tk20dk/elmo/kicad/elmo-pcb.png

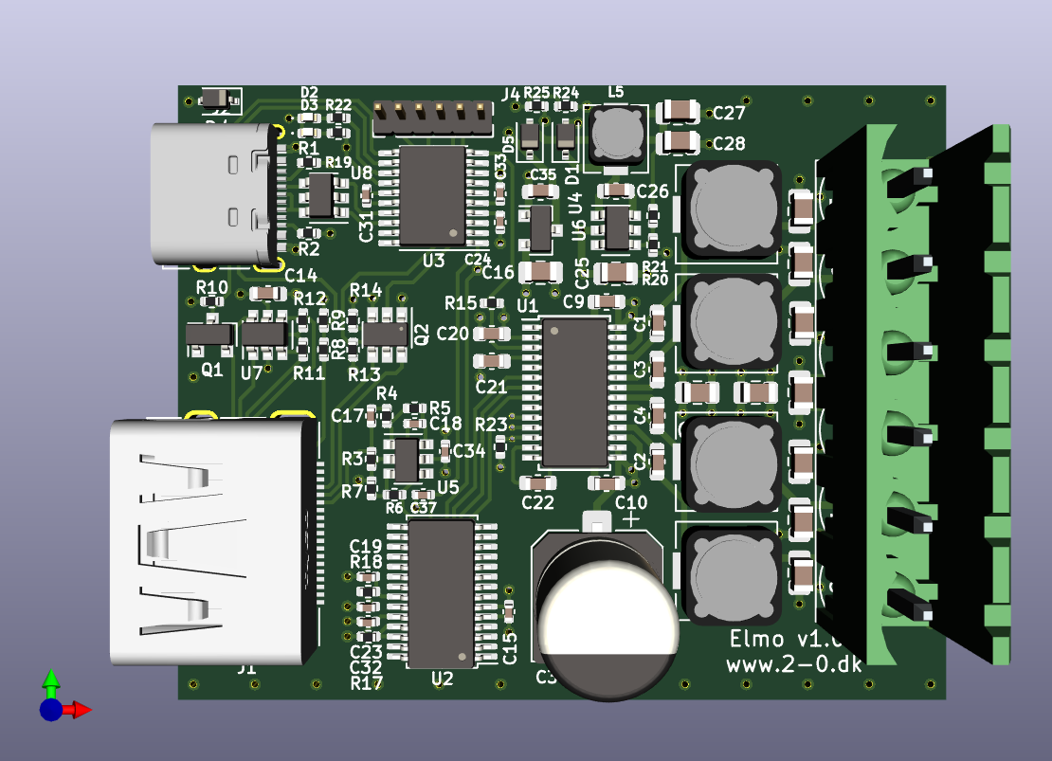
kicad/elmo-pcb.png
