tk20dk/elmo/kicad/elmo-pcb.pdf

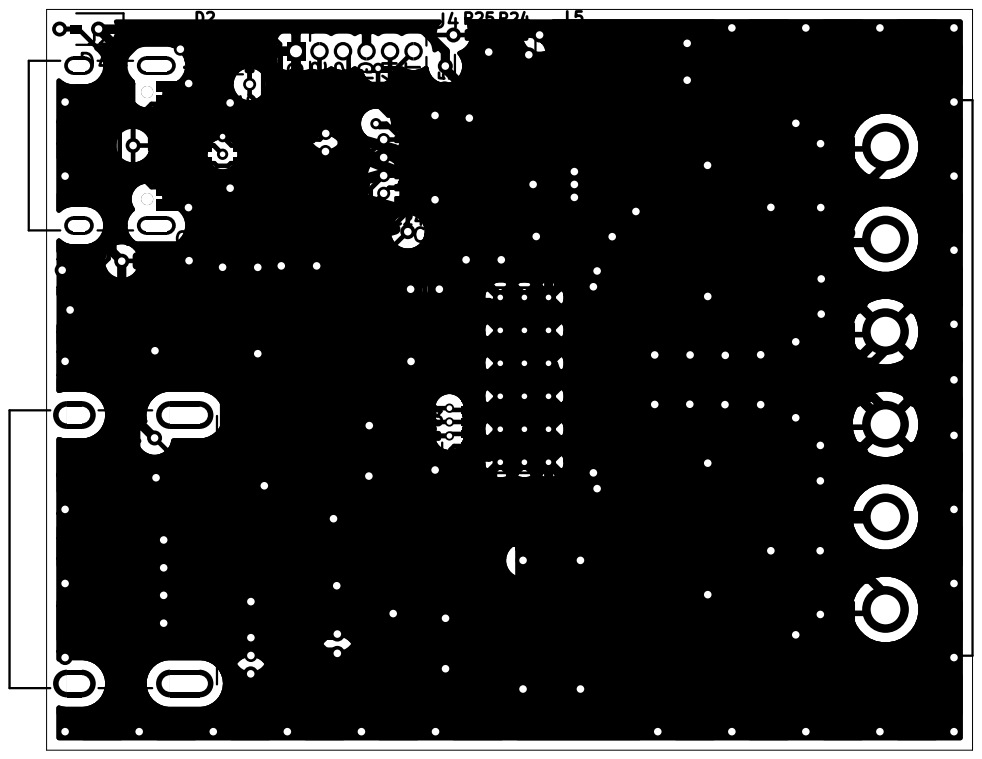
[picture p2: page 1]
