tk20dk/elmo/kicad/elmo-sch.pdf

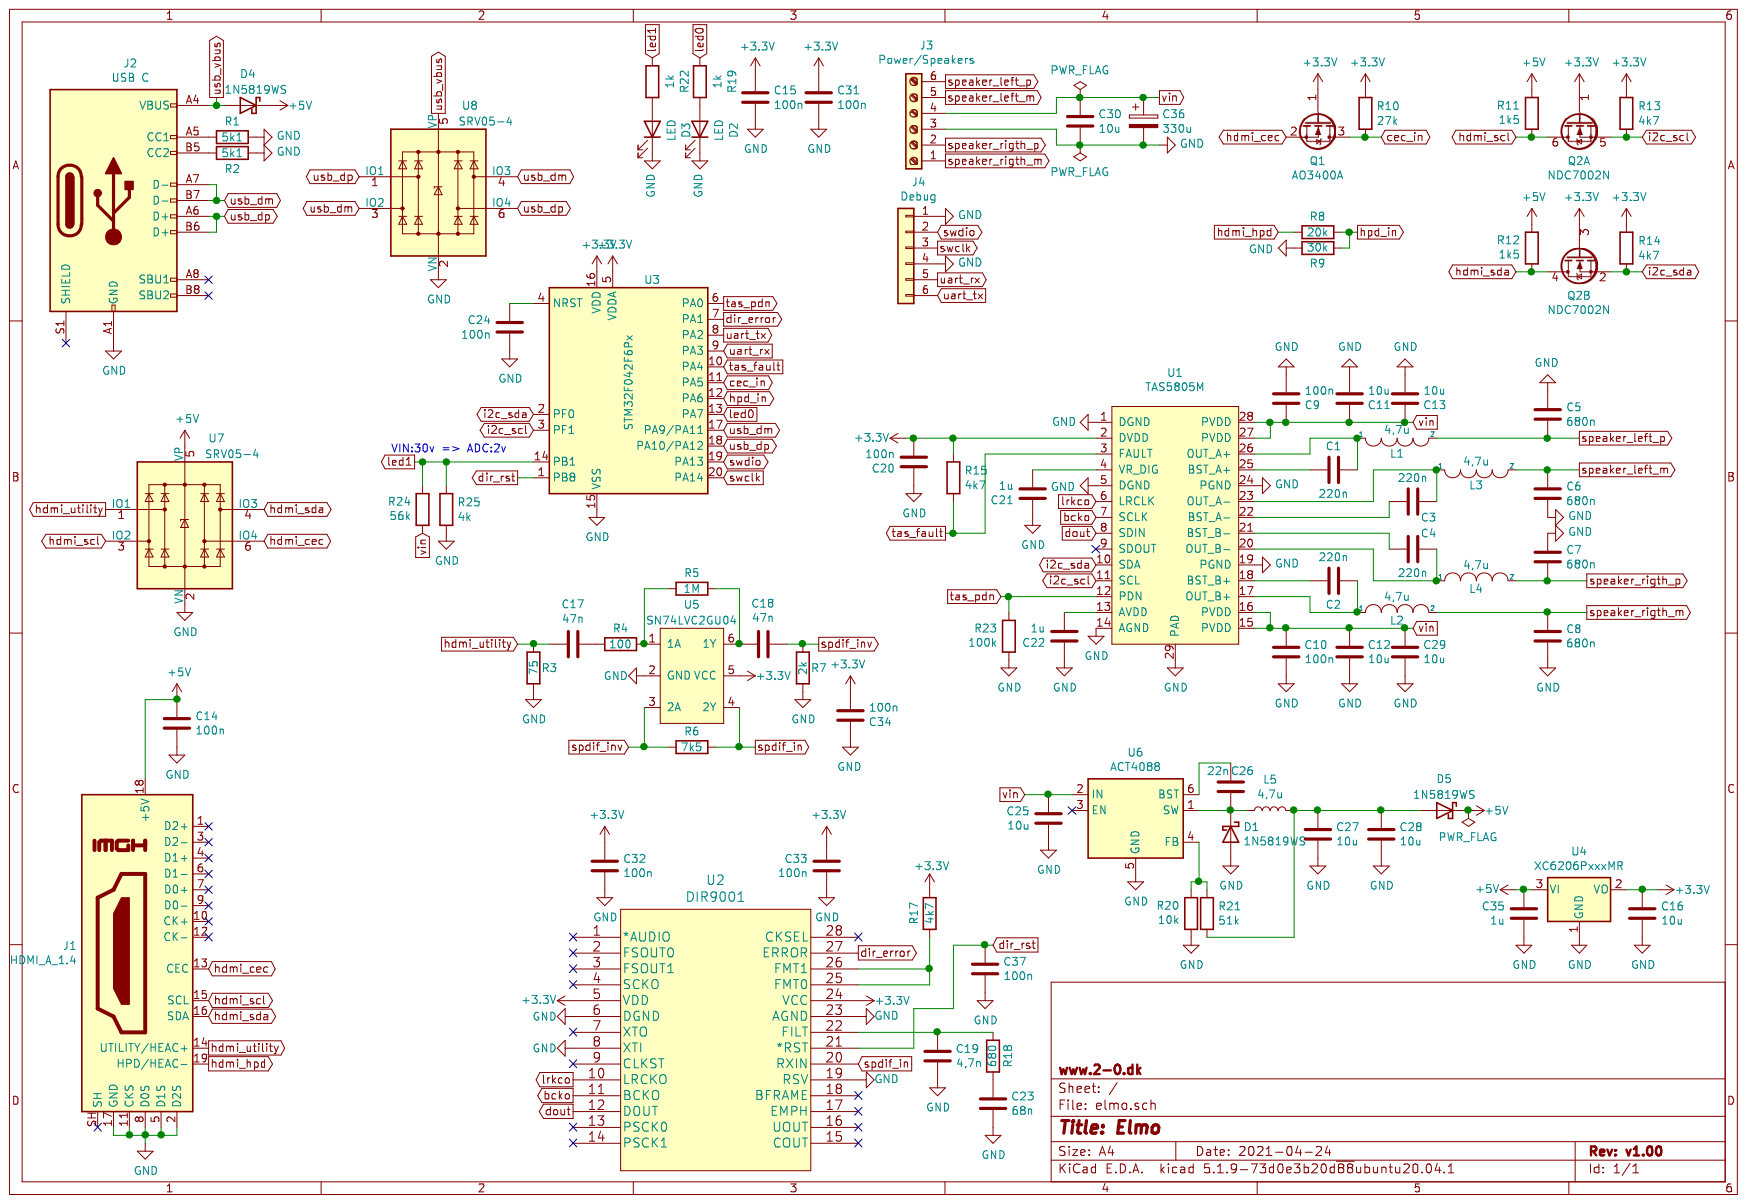
[picture p3: page 1]
