tk20dk/elmo/kicad/elmo.kicad_pcb

## KiCad design kicad/elmo.kicad_pcb (2021-04-25)

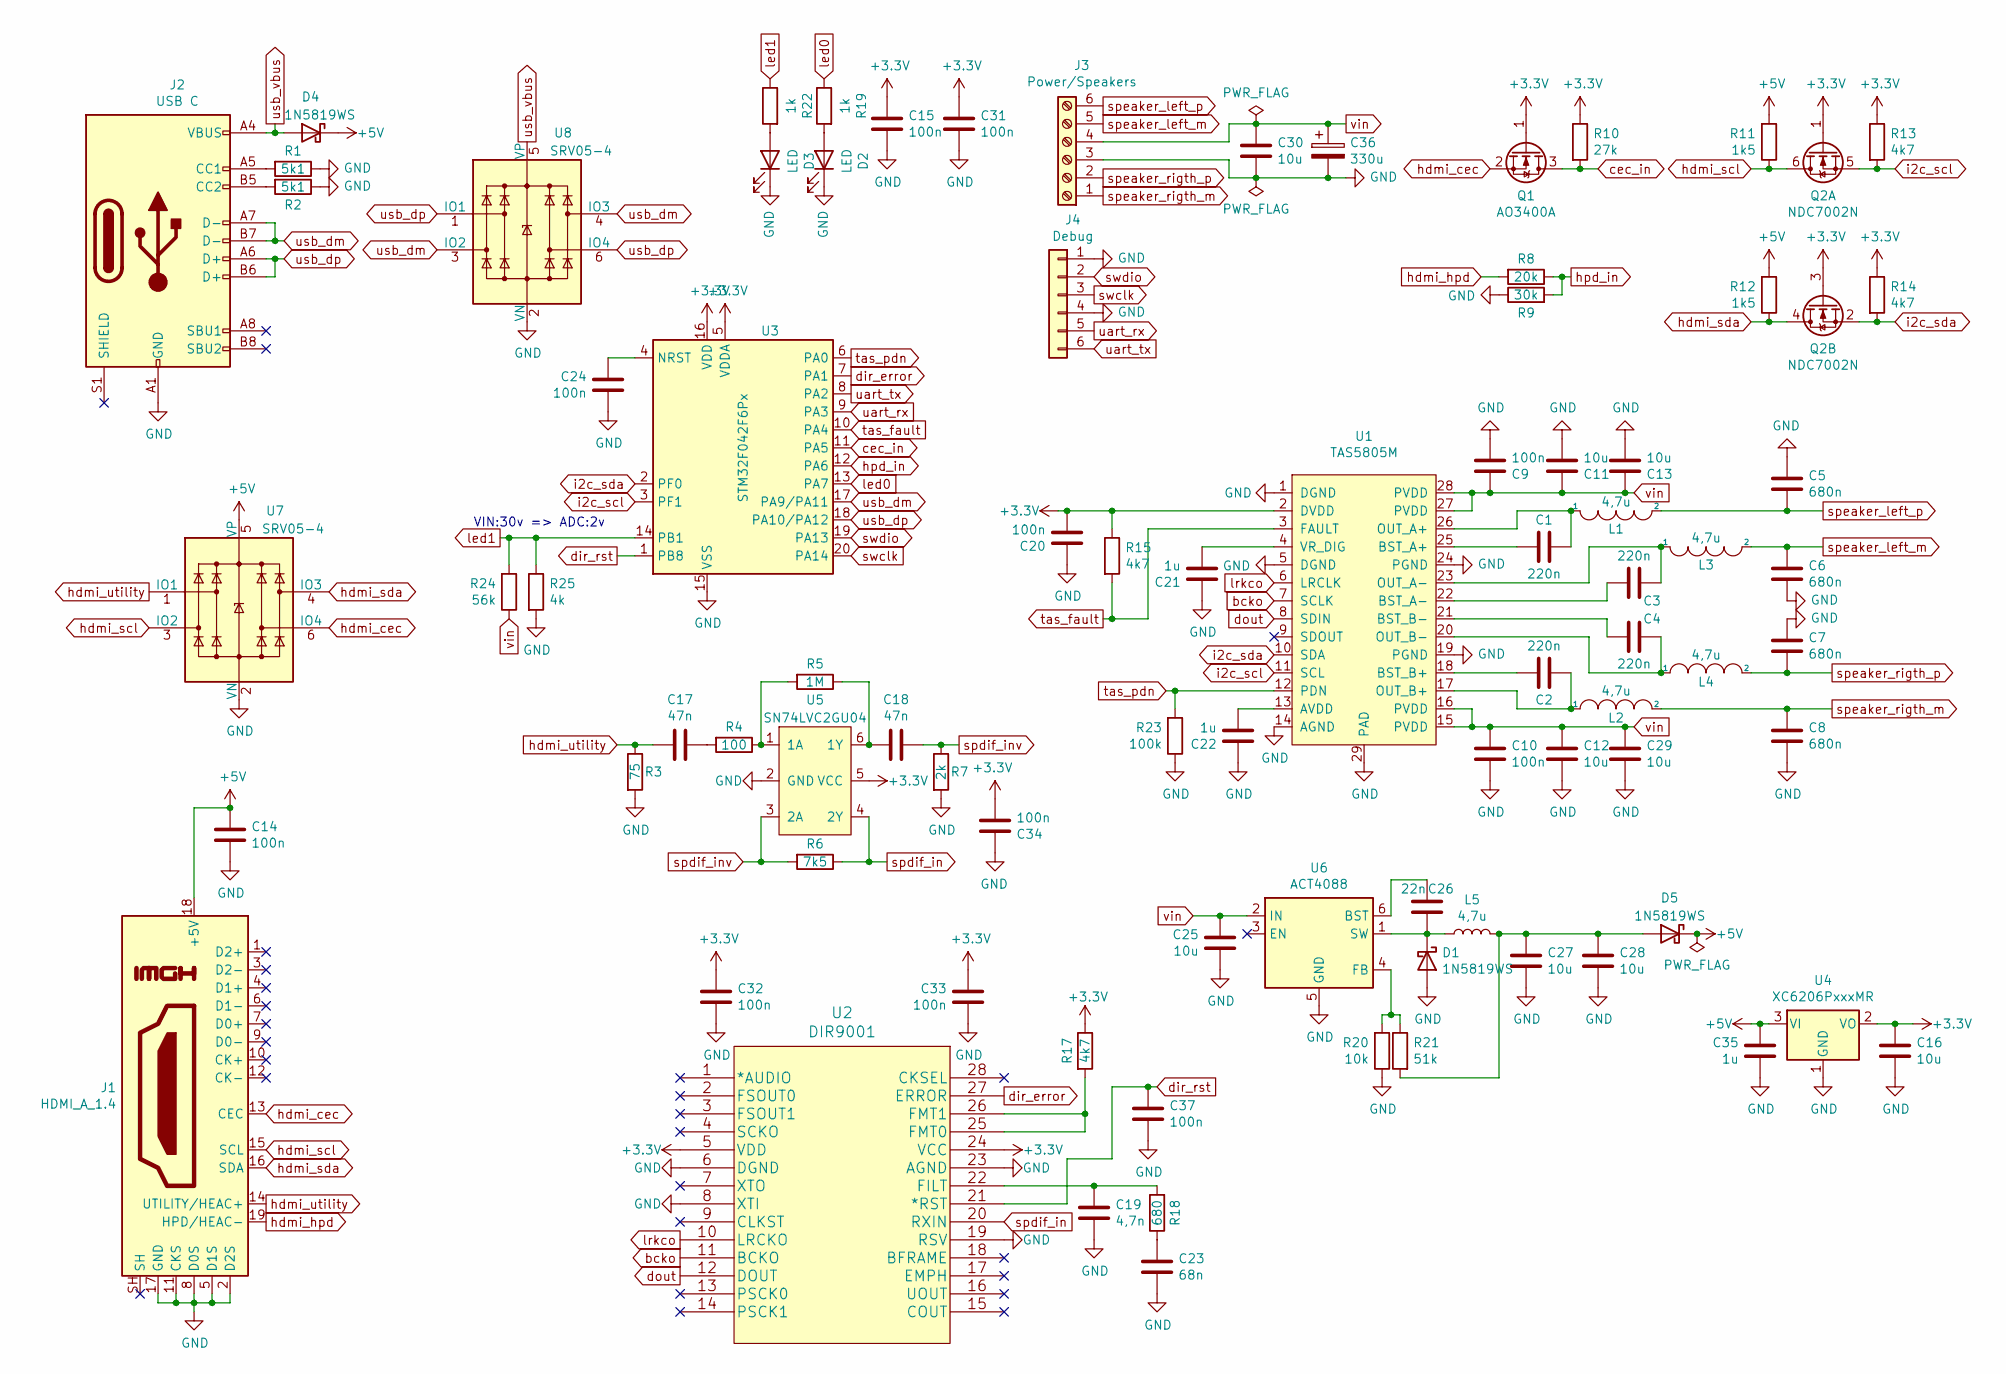
[picture p4: schematic elmo.sch]

Parts:
C1, C2, C3, C4: 220n; C_0603_1608Metric
C5, C6, C7, C8: 680n; C_0805_2012Metric
C9, C10, C14, C20: 100n; C_0603_1608Metric
C11, C12, C13, C16, C25, C27, C28, C29, C30: 10u; C_0805_2012Metric
C15, C24, C31, C32, C33, C34, C37: 100n; C_0402_1005Metric
C17, C18: 47n; C_0402_1005Metric
C19: 4,7n; C_0402_1005Metric
C21, C22, C35: 1u; C_0603_1608Metric
C23: 68n; C_0402_1005Metric
C26: 22n; C_0603_1608Metric
C36: 330u; CP_Elec_8x11.9
D1, D4, D5: 1N5819WS; D_SOD-323
D2, D3: LED; LED_0402_1005Metric
J1: HDMI_A_1.4; HDMI_A_19P
J2: USB C; USB_C_Receptacle_XKB_U262-16XN-4BVC11
J3: Power/Speakers; CONN_5MM_01x06
J4: Debug; PinHeader_1x06_P1.27mm_Vertical
L1, L2, L3, L4: 4,7u; L_6.3x6.3_H3
L5: 4,7u; L_4.1x4.1_H1.75
Q1: AO3400A; SOT-23
Q2: NDC7002N; SuperSOT-6
R1, R2: 5k1; R_0402_1005Metric
R3: 75; R_0402_1005Metric
R4: 100; R_0402_1005Metric
R5: 1M; R_0402_1005Metric
R6: 7k5; R_0402_1005Metric
R7: 2k; R_0402_1005Metric
R8: 20k; R_0402_1005Metric
R9: 30k; R_0402_1005Metric
R10: 27k; R_0402_1005Metric
R11, R12: 1k5; R_0402_1005Metric
R13, R14, R15, R17: 4k7; R_0402_1005Metric
R18: 680; R_0402_1005Metric
R19, R22: 1k; R_0402_1005Metric
R20: 10k; R_0402_1005Metric
R21: 51k; R_0402_1005Metric
R23: 100k; R_0402_1005Metric
R24: 56k; R_0402_1005Metric
R25: 4k; R_0402_1005Metric
U1: TAS5805M; HTSSOP-28-1EP_4.4x9.7mm_P0.65mm_EP3.4x9.5mm_Mask2.4x6.17mm_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
U2: DIR9001; TSSOP-28_4.4x9.7mm_P0.65mm
U3: STM32F042F6Px; TSSOP-20_4.4x6.5mm_P0.65mm
U4: XC6206PxxxMR; SOT-23
U5: SN74LVC2GU04; SOT-23-6
U6: ACT4088; SOT-23-6
U7, U8: SRV05-4; SOT-23-6

Connections:
+3V3: C15.1, C16.1, C20.2, C31.1, C32.1, C33.1, C34.2, Q1.1 (G), Q2.1 (G), Q2.3 (G), R10.1, R13.1, R14.1, R15.1, R17.1, U1.2 (DVDD), U2.5 (VDD), U2.24 (VCC), U3.5 (VDDA), U3.16 (VDD), U4.2 (VO), U5.5 (VCC)
+5V: C14.1, C35.1, D4.1 (K), D5.1 (K), J1.18 (+5V), R11.2, R12.2, U4.3 (VI), U7.5 (VP)
GND: C5.1, C6.2, C7.1, C8.2, C9.2, C10.2, C11.2, C12.2, C13.2, C14.2, C15.2, C16.2, C19.2, C20.1, C21.1, C22.1, C23.2, C24.2, C25.2, C27.2, C28.2, C29.2, C30.2, C31.2, C32.2, C33.2, C34.1, C35.2, C36.2, C37.2, D1.2 (A), D2.1 (K), D3.1 (K), J1.2 (D2S), J1.5 (D1S), J1.8 (D0S), J1.11 (CKS), J1.17 (GND), J2.A1 (GND), J2.A12 (GND), J2.B1 (GND), J2.B12 (GND), J3.3, J4.1, J4.4, R1.1, R2.1, R3.2, R7.2, R9.1, R20.1, R23.1, R25.2, U1.1 (DGND), U1.5 (DGND), U1.14 (AGND), U1.19 (PGND), U1.24 (PGND), U1.29 (PAD), U2.6 (DGND), U2.8 (XTI), U2.19 (RSV), U2.23 (AGND), U3.15 (VSS), U4.1 (GND), U5.2 (GND), U6.5 (GND), U7.2 (VN), U8.2 (VN)
unnamed: C1.1, U1.25 (BST_A+)
unnamed: C1.2, L1.1, U1.26 (OUT_A+)
unnamed: C2.1, U1.18 (BST_B+)
unnamed: C2.2, L2.1, U1.17 (OUT_B+)
unnamed: C3.1, U1.22 (BST_A-)
unnamed: C3.2, L3.1, U1.23 (OUT_A-)
unnamed: C4.1, U1.21 (BST_B-)
unnamed: C4.2, L4.1, U1.20 (OUT_B-)
unnamed: C17.1, R4.2
unnamed: C18.1, R5.1, U5.6 (1Y)
unnamed: C19.1, R18.2, U2.22 (FILT)
unnamed: C21.2, U1.4 (VR_DIG)
unnamed: C22.2, U1.13 (AVDD)
unnamed: C23.1, R18.1
unnamed: C24.1, U3.4 (NRST)
unnamed: C26.1, U6.6 (BST)
unnamed: C26.2, D1.1 (K), L5.1, U6.1 (SW)
unnamed: C27.1, C28.1, D5.2 (A), L5.2, R21.2
unnamed: D2.2 (A), R19.2
unnamed: D3.2 (A), R22.2
unnamed: J2.A5 (CC1), R1.2
unnamed: J2.B5 (CC2), R2.2
unnamed: R4.1, R5.2, U5.1 (1A)
unnamed: R17.2, U2.25 (FMT0), U2.26 (FMT1)
unnamed: R20.2, R21.1, U6.4 (FB)
bcko: U1.7 (SCLK), U2.11 (BCKO)
cec_in: Q1.3 (D), R10.2, U3.11 (PA5)
dir_error: U2.27 (ERROR), U3.7 (PA1)
dir_rst: C37.1, U2.21 (*RST), U3.1 (PB8)
dout: U1.8 (SDIN), U2.12 (DOUT)
hdmi_cec: J1.13 (CEC), Q1.2 (S), U7.6 (IO4)
hdmi_hpd: J1.19 (HPD/HEAC-), R8.2
hdmi_scl: J1.15 (SCL), Q2.6 (D), R11.1, U7.3 (IO2)
hdmi_sda: J1.16 (SDA), Q2.4 (D), R12.1, U7.4 (IO3)
hdmi_utility: C17.2, J1.14 (UTILITY/HEAC+), R3.1, U7.1 (IO1)
hpd_in: R8.1, R9.2, U3.12 (PA6)
i2c_scl: Q2.5 (S), R13.2, U1.11 (SCL), U3.3 (PF1)
i2c_sda: Q2.2 (S), R14.2, U1.10 (SDA), U3.2 (PF0)
led0: R19.1, U3.13 (PA7)
led1: R22.1, R24.2, R25.1, U3.14 (PB1)
lrkco: U1.6 (LRCLK), U2.10 (LRCKO)
spdif_in: R6.1, U2.20 (RXIN), U5.4 (2Y)
spdif_inv: C18.2, R6.2, R7.1, U5.3 (2A)
speaker_left_m: C6.1, J3.5, L3.2
speaker_left_p: C5.2, J3.6, L1.2
speaker_rigth_m: C8.1, J3.1, L2.2
speaker_rigth_p: C7.2, J3.2, L4.2
swclk: J4.3, U3.20 (PA14)
swdio: J4.2, U3.19 (PA13)
tas_fault: R15.2, U1.3 (FAULT), U3.10 (PA4)
tas_pdn: R23.2, U1.12 (PDN), U3.6 (PA0)
uart_rx: J4.5, U3.9 (PA3)
uart_tx: J4.6, U3.8 (PA2)
usb_dm: J2.A7 (D-), J2.B7 (D-), U3.17 (PA9/PA11), U8.3 (IO2), U8.4 (IO3)
usb_dp: J2.A6 (D+), J2.B6 (D+), U3.18 (PA10/PA12), U8.1 (IO1), U8.6 (IO4)
usb_vbus: D4.2 (A), J2.A4 (VBUS), J2.A9 (VBUS), J2.B4 (VBUS), J2.B9 (VBUS), U8.5 (VP)
vin: C9.1, C10.1, C11.1, C12.1, C13.1, C25.1, C29.1, C30.1, C36.1, J3.4, R24.1, U1.15 (PVDD), U1.16 (PVDD), U1.27 (PVDD), U1.28 (PVDD), U6.2 (IN)

Notes on the sheet:
VIN:30v => ADC:2v

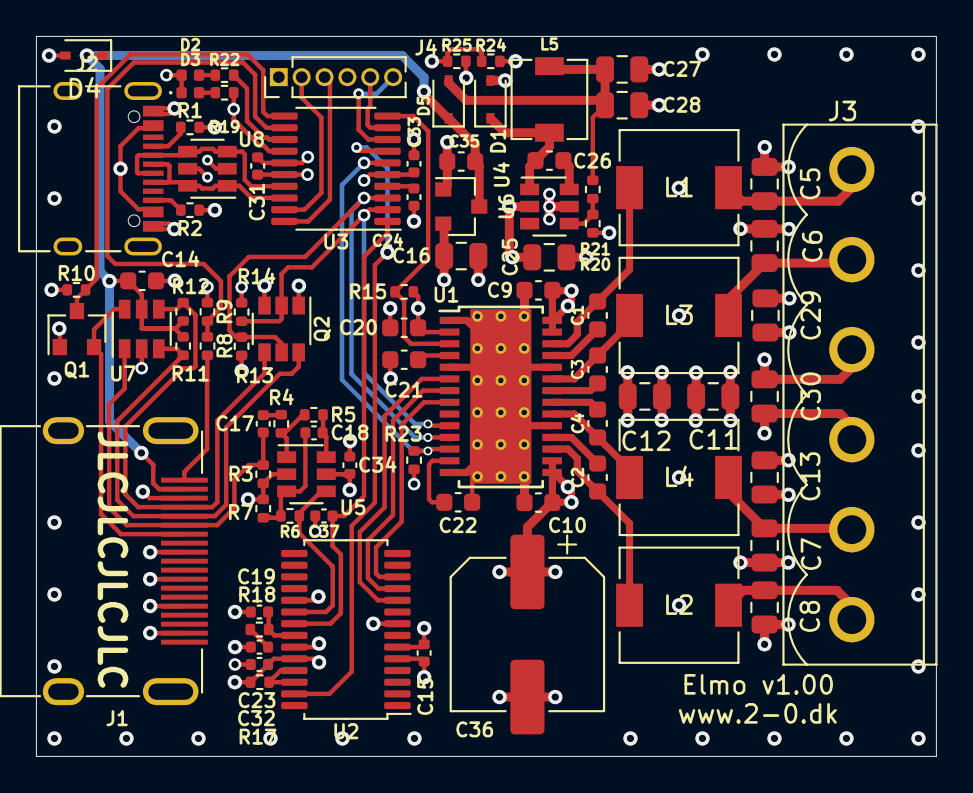
[picture p5: board elmo.kicad_pcb from above]

Board: 4 copper layers, 50.0 x 40.0 mm, 85 parts (0 on the bottom side), 60 nets.
