tk20dk/elmo/stm32/Core/Inc/main.h

#define DIR_RST_Pin GPIO_PIN_8
#define DIR_RST_GPIO_Port GPIOB
#define TAS_PDN_Pin GPIO_PIN_0
#define TAS_PDN_GPIO_Port GPIOA
#define DIR_ERROR_Pin GPIO_PIN_1
#define DIR_ERROR_GPIO_Port GPIOA
#define TAS_FAULT_Pin GPIO_PIN_4
#define TAS_FAULT_GPIO_Port GPIOA
#define CEC_IN_Pin GPIO_PIN_5
#define CEC_IN_GPIO_Port GPIOA
#define HPD_IN_Pin GPIO_PIN_6
#define HPD_IN_GPIO_Port GPIOA
#define HMI_LED0_Pin GPIO_PIN_7
#define HMI_LED0_GPIO_Port GPIOA
#define HMI_LED1_Pin GPIO_PIN_1
#define HMI_LED1_GPIO_Port GPIOB
